pietrmar/theadmouse/hardware/RevA/Pin Assignment.ods

Pin
Module | nRF52840 | ADC | Fast-IO | Signal
1 | P1.11 |  |  | BTN_JACK_3
2 | P1.10 |  |  | BTN_JACK_2
3 | P0.03 | AIN1 |  | /SENS_MAG_CS
4 | P0.28 | AIN4 |  | VBAT_MEAS
5 | GND |  |  | GND
6 | P1.13 |  |  | BTN_JACK_1
7 | P0.02 | AIN0 |  | BTN_MFB
8 | P0.29 | AIN5 |  | SENS_MAG_DRDY
9 | P0.31 | AIN7 |  | SENS_IMU_INT_2
10 | P0.30 | AIN6 |  | SENS_IMU_INT_1
11 | P0.00 (XL1) |  | Yes | Y1
12 | P0.26 |  | Yes | LED_R
13 | P0.01 (XL2) |  | Yes | Y1
14 | P0.06 |  | Yes | LED_G
15 | P0.05 | AIN3 | Yes | SENS_SPI_MOSI
16 | P0.08 |  | Yes | LED_B
17 | P1.09 |  | Yes | SENS_SPI_SCLK
18 | P0.04 | AIN2 | Yes | SENS_SPI_MISO
19 | VDD |  |  | VDD_3V3
20 | P0.12 |  | Yes | EXT_I2C_SCL
21 | GND |  |  | GND
22 | P0.07 |  | Yes | EXT_I2C_SDA
23 | VDDH |  |  | VDD_3V3
24 | GND |  |  | GND
25 | DCCH |  |  | N.C.
26 | P0.18 (RESET) |  | Yes | /RESET
27 | VBUS |  |  | VBUS
28 | P0.15 |  | Yes | SPK_PWM
29 | USB_DN |  |  | USB_D-
30 | P0.17 |  | Yes | CHRG_I2C_SCL
31 | UDB_DP |  |  | USB_D+
32 | P0.20 |  | Yes | CHRG_I2C_SDA
33 | P0.13 |  | Yes | EXT_GPIO_1
34 | P0.22 |  | Yes | UART_TX
35 | P0.24 |  | Yes | UART_RX
36 | P1.00 (SWO) |  | Yes | SWO
37 | SWDIO |  |  | SWDIO
38 | P1.02 |  |  | /EXT_3V3_FAULT
39 | SWCLK |  |  | SWCLK
40 | P1.04 |  |  | EXT_3V3_EN
41 | P0.09 (NFC1) |  |  | EXT_GPIO_2
42 | P1.06 |  |  | /CHRG_INT
43 | P0.10 (NFC2) |  |  | /SENS_IMU_CS
