pietrmar/theadmouse/hardware/RevA/Stackup.ods

JLCPCB Stackup: JLC04161H-3313
Layer | Material | Thickness [mm] | εr | Signal | Mode | Target Z [Ω] | Width [mm] | Spacing [mm] | Actual Z [Ω]
L1 (Top) | Copper | 0.035 |  | SPI | Single-Ended | 50 | 0.15 |  | 49.815
Prepreg | 3313*1 | 0.0994 | 4.1 | USB | Differential | 90 | 0.15 | 0.17 | 90.38
L2 (Inner) | Copper | 0.0152
Core | Core | 1.265 | 4.6
L3 (Inner) | Copper | 0.0152
Prepreg | 3313*1 | 0.0994 | 4.1
L4 (Bottom) | Copper | 0.035
