pietrmar/theadmouse/hardware/3dmodels/SW_Push_1P1T-MP_NO_Horizontal_Alps_SKRTLAE010_Custom3D.step

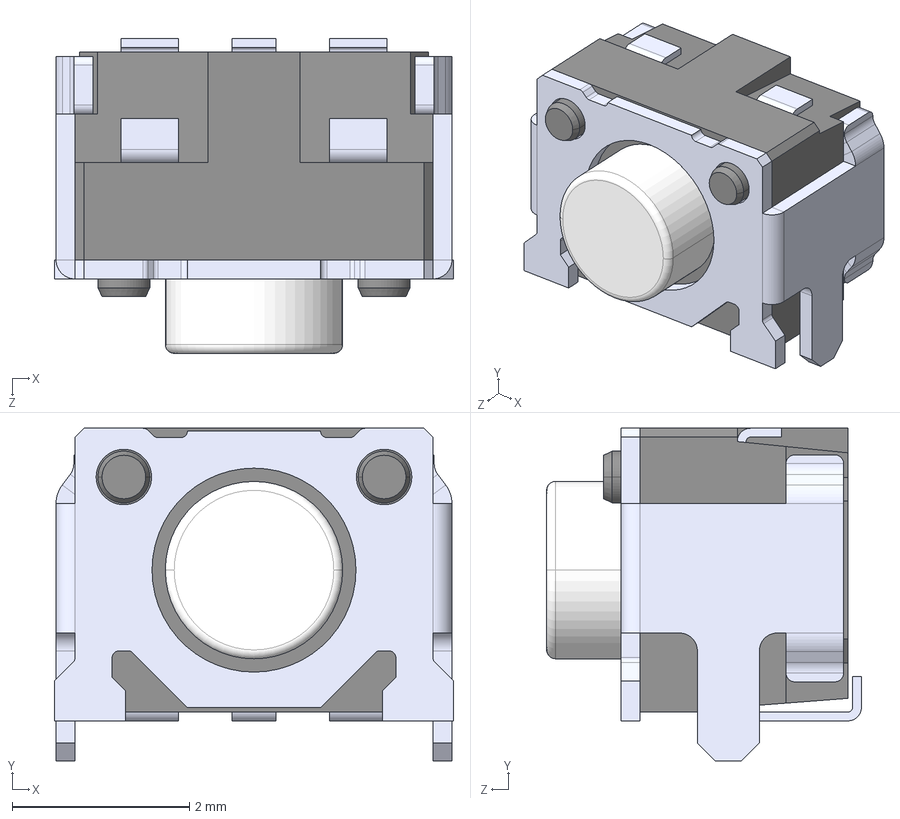
[picture p1: CAD file, 2025-08-08]
hardware/3dmodels/SW_Push_1P1T-MP_NO_Horizontal_Alps_SKRTLAE010_Custom3D.step
4.50 x 3.75 x 3.55 mm
