pietrmar/theadmouse/hardware/mechanical/components/LED_RGB_TUOZHAN_P4-1204RGBWS2-1.5T-A_Horizontal.FCStd

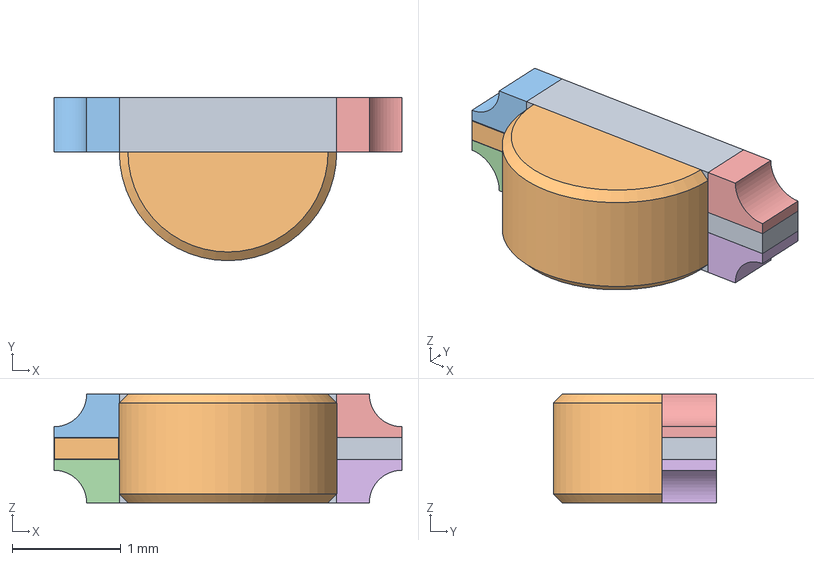
[picture p2: CAD file, 2025-08-08]
hardware/mechanical/components/LED_RGB_TUOZHAN_P4-1204RGBWS2-1.5T-A_Horizontal.FCStd
3.20 x 1.50 x 1.00 mm
Pad002 (Mirror #1)
Pad002 (Mirror #2)
Pad002 (Mirror #3)
Pad003 (Mirror #4)
