pietrmar/theadmouse/hardware/3dmodels/RJ25_TE_215876-1_Horizontal.step

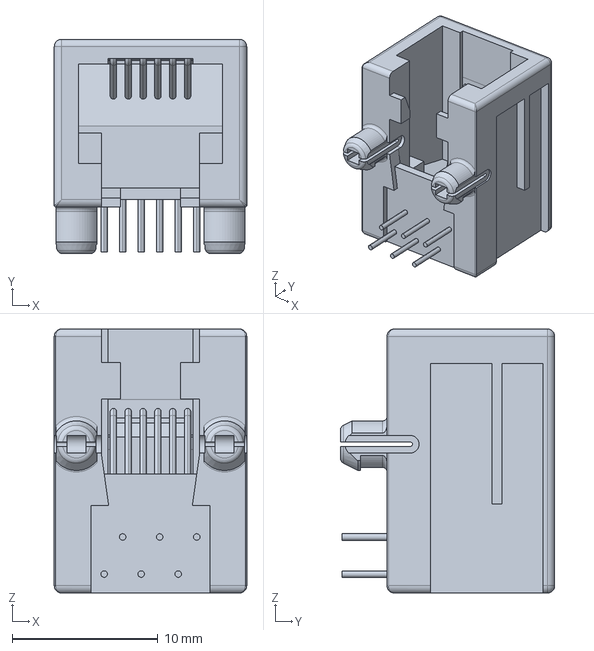
[picture p3: CAD file, 2025-08-08]
hardware/3dmodels/RJ25_TE_215876-1_Horizontal.step
13.2 x 14.7 x 18.1 mm
