pietrmar/theadmouse/hardware/mechanical/components/Buzzer_FUET_FST-9018_9x9mm.FCStd

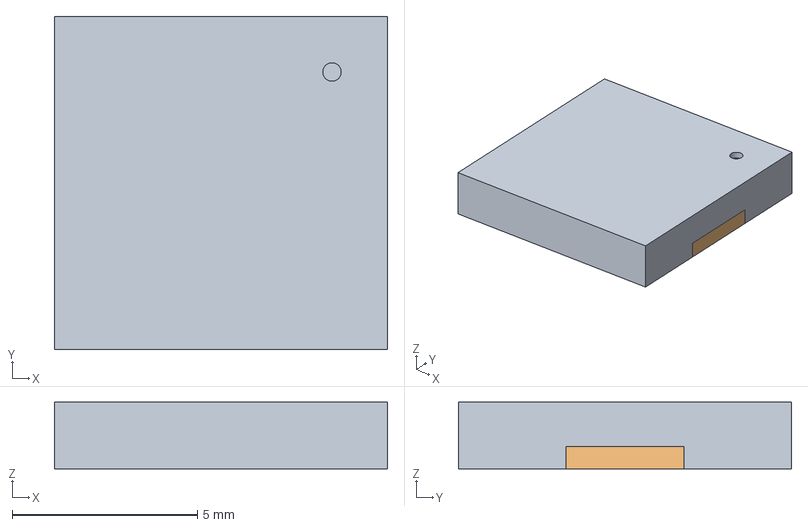
[picture p4: CAD file, 2025-08-08]
hardware/mechanical/components/Buzzer_FUET_FST-9018_9x9mm.FCStd
9.00 x 9.00 x 1.80 mm
Pad001 (Mirror #1)
