pietrmar/theadmouse/hardware/3dmodels/USB_C_Receptacle_HRO_TYPE-C-31-M-12_Custom3D.step

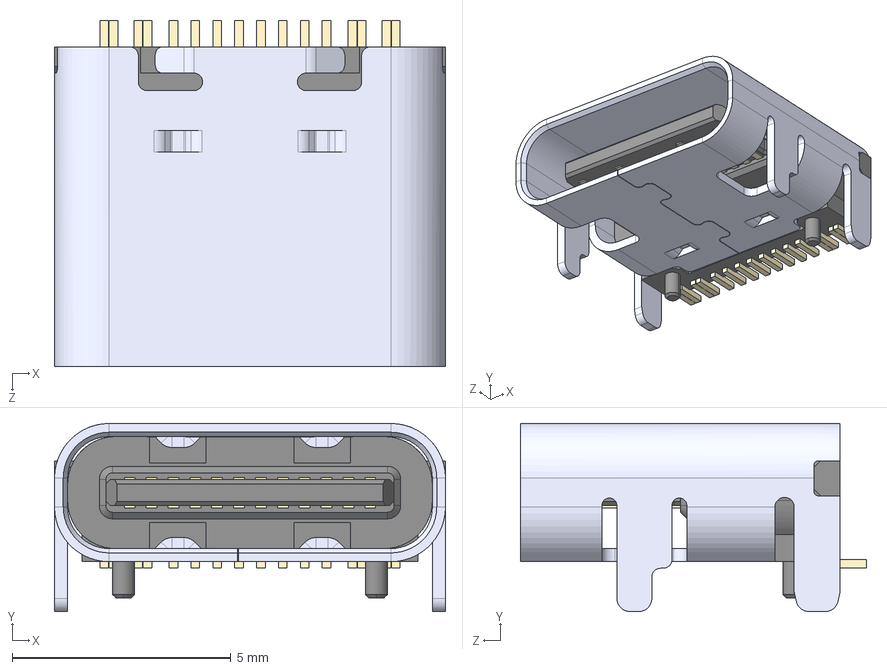
[picture p5: CAD file, 2025-08-08]
hardware/3dmodels/USB_C_Receptacle_HRO_TYPE-C-31-M-12_Custom3D.step
8.94 x 4.30 x 7.90 mm
