pietrmar/theadmouse/hardware/mechanical/components/LED_Green_MEIHUA_MHS110UGCT_Horizontal.FCStd

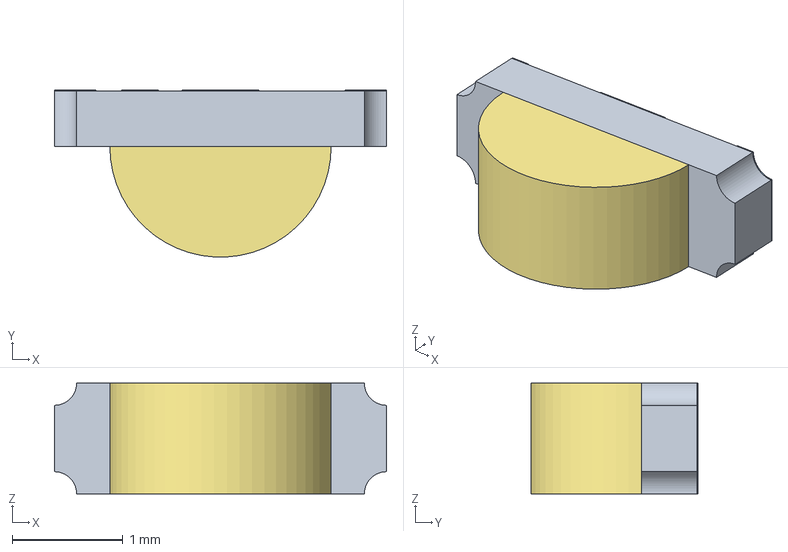
[picture p6: CAD file, 2025-08-08]
hardware/mechanical/components/LED_Green_MEIHUA_MHS110UGCT_Horizontal.FCStd
3.00 x 1.51 x 1.00 mm
Body001 (Mirror #1)
CopyPad001
