pietrmar/theadmouse/hardware/3dmodels/Jack_3.5mm_KoreanHropartsElec_PJ-320D-4A_Horizontal_Custom.step

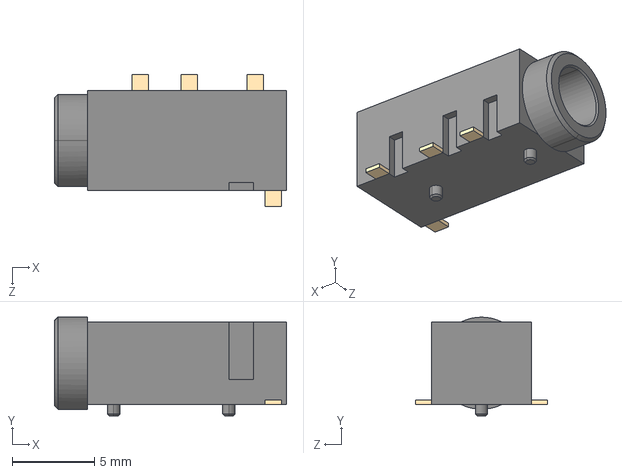
[picture p7: CAD file, 2025-08-08]
hardware/3dmodels/Jack_3.5mm_KoreanHropartsElec_PJ-320D-4A_Horizontal_Custom.step
14.1 x 6.00 x 8.00 mm
