pietrmar/theadmouse/hardware/3dmodels/SW_SPDT_ALPS_SSSS811101_SMT_Horizontal.step

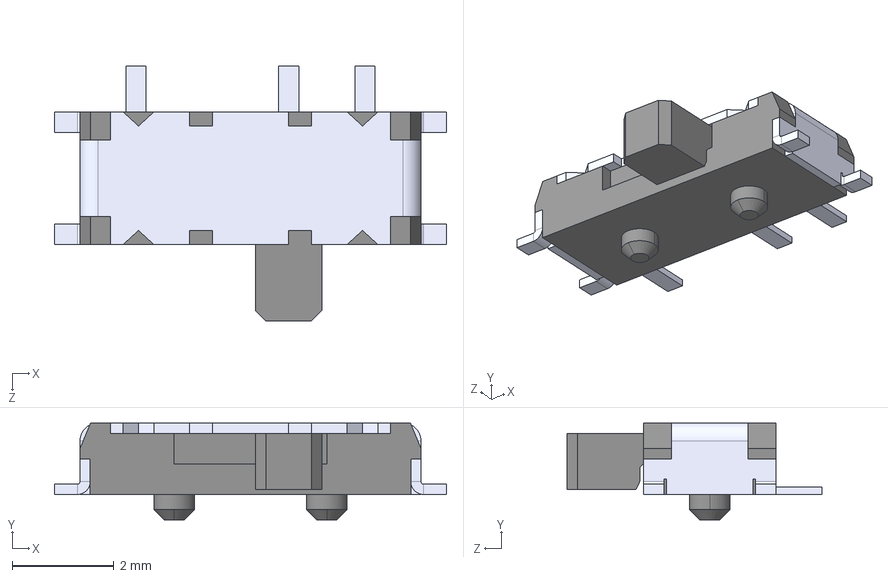
[picture p8: CAD file, 2025-08-08]
hardware/3dmodels/SW_SPDT_ALPS_SSSS811101_SMT_Horizontal.step
7.70 x 1.90 x 5.00 mm
