pietrmar/theadmouse/hardware/3dmodels/Module_RF_Ebyte_E73-2G4M08S1C_Castellated.step

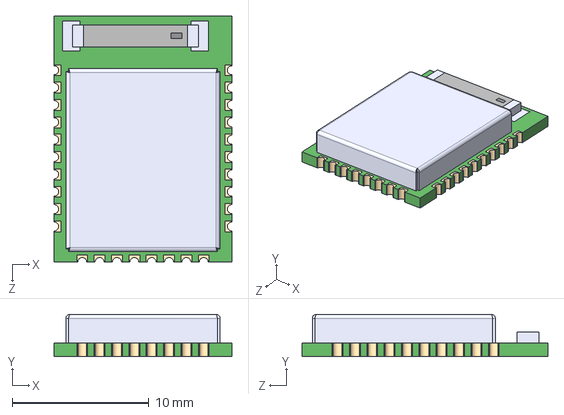
[picture p9: CAD file, 2025-08-08]
hardware/3dmodels/Module_RF_Ebyte_E73-2G4M08S1C_Castellated.step
13.0 x 3.10 x 18.0 mm
