pietrmar/theadmouse/hardware/RevA/pcb/theadmouse.kicad_pcb

## KiCad design hardware/RevA/pcb/theadmouse.kicad_pcb (2026-05-12)

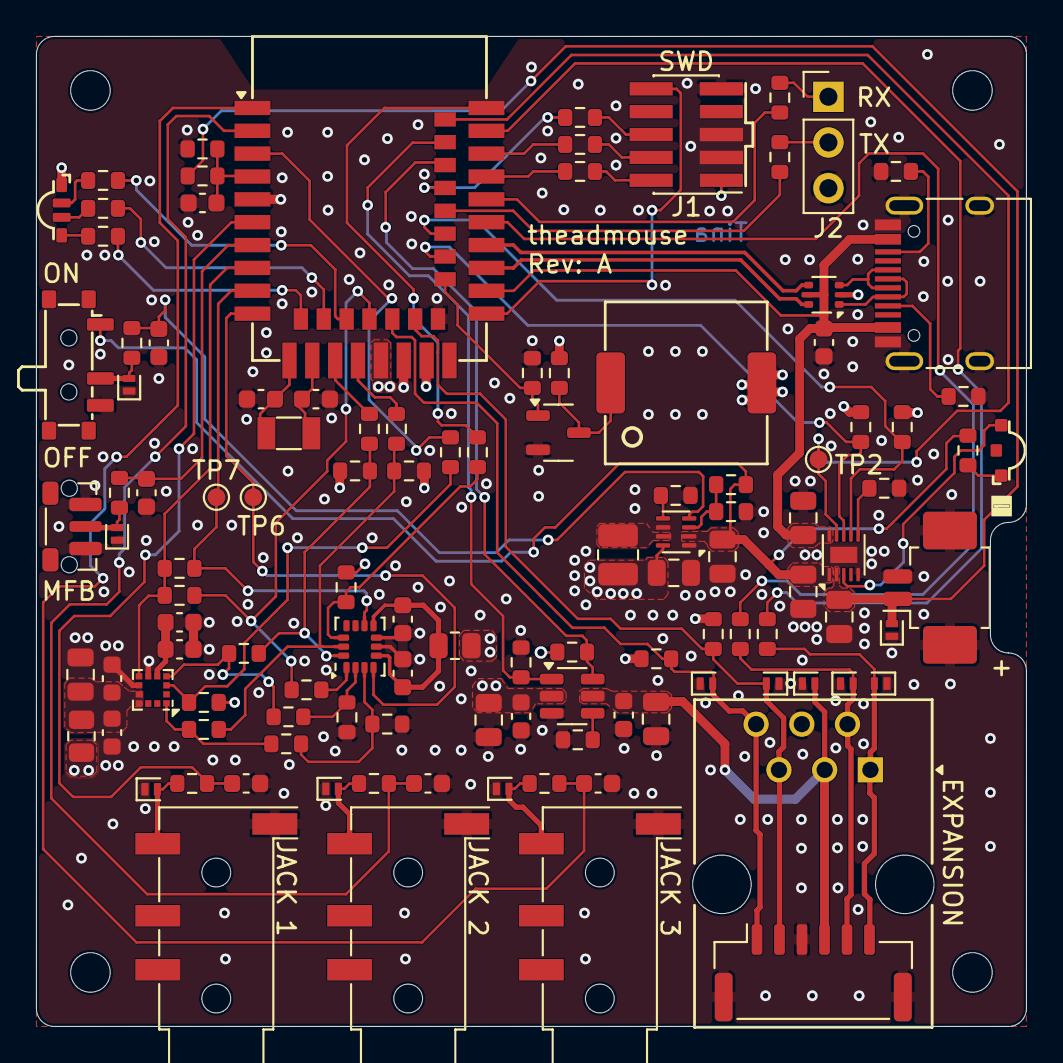
[picture p10: board theadmouse.kicad_pcb from above]

Board: 4 copper layers, 55.0 x 55.0 mm, 119 parts (0 on the bottom side), 82 nets.

Parts:
C1, C2: 15p; C_0603_1608Metric
C3, C8, C11, C13, C14, C15, C16, C17, C19, C26: 100n; C_0603_1608Metric
C4, C5, C6, C9, C10, C12, C18, C25: 10u; C_0805_2012Metric
C7, C21, C22, C23, C24: 10n; C_0603_1608Metric
D1, D2, D3, D4, D5, D6, D7, D8, D9, D10, D12: H5VL10B; D_SOD-882
D11: LED_STATUS; LED_RGB_TUOZHAN_P4-1204RGBWS2-1.5T-A_Horizontal
D13: LED_PGOOD; LED_Green_MEIHUA_MHS110UGCT_Horizontal
H1, H2, H3, H4: MountingHole; MountingHole_2.2mm_M2_ISO7380
J1: CON_SWD; PinHeader_2x05_P1.27mm_Vertical_SMD
J2: CON_UART; PinHeader_1x03_P2.54mm_Vertical
J4: TYPE-C-31-M-12; USB_C_Receptacle_HRO_TYPE-C-31-M-12_Custom3D
J5: CON_BAT; Molex_PicoBlade_53261-0271_1x02-1MP_P1.25mm_Horizontal
J6: CON_EXT; JST_GH_SM06B-GHS-TB_1x06-1MP_P1.25mm_Horizontal
J7: CON_EXT_RJ; RJ25_TE_215876-1_Horizontal
J8, J9, J10: PJ-320D-4A; Jack_3.5mm_KoreanHropartsElec_PJ-320D-4A_Horizontal_Custom
L1: 2u2; L_1008_2520Metric
LS1: FUET-9018; Buzzer_FUET_FST-9018_9x9mm
Q1: HL2312; SOT-23-3
R1, R2, R3, R4, R5, R6, R21, R30: 10k; R_0603_1608Metric
R7, R8, R11, R12, R41, R44, R45, R49: 100R; R_0603_1608Metric
R9, R10, R13, R14, R16, R17, R18, R53: 22R; R_0603_1608Metric
R19, R20: 5k1; R_0603_1608Metric
R22: 4M02; R_0603_1608Metric
R23: 10M; R_0603_1608Metric
R24, R26, R32, R34, R35, R36, R37, R38, R39, R40: 0R; R_0603_1608Metric
R25, R43: 100k; R_0603_1608Metric
R27: 4k3; R_0603_1608Metric
R28: 267k; R_0603_1608Metric
R29, R50, R51: 470k; R_0603_1608Metric
R31, R33: 0R; R_0805_2012Metric
R42: 1k; R_0603_1608Metric
R46: 470R; R_0603_1608Metric
R47: 390R; R_0603_1608Metric
R48: 270R; R_0603_1608Metric
R52: 1k5; R_0603_1608Metric
SW1: SW_PWR; SW_SPDT_ALPS_SSSS811101_SMT_Horizontal
SW2: SW_MFB; SW_Push_1P1T-MP_NO_Horizontal_Alps_SKRTLAE010_Custom3D
TP2: ~{CHRG_INT}; TestPoint_Pad_D1.0mm
TP6: SENS_IMU_INT1; TestPoint_Pad_D1.0mm
TP7: SENS_IMU_INT2; TestPoint_Pad_D1.0mm
U1: E73-2G4M08S1C; Module_RF_Ebyte_E73-2G4M08S1C_Castellated
U2: USBLC6-2P6; SOT-666
U3: BQ25186; Texas_DLH0010A_WSON-10-1EP_2.2x2mm_P0.4mm_EP0.9x1.5mm
U4: TPS22950; SOT-23-6
U5: TPS62840DLC; Texas_VSON-HR-8_1.5x2mm_P0.5mm
U6: LSM6DSL; LGA-14_3x2.5mm_P0.5mm_LayoutBorder3x4y
U7: LIS2MDL; LGA-12_2x2mm_P0.5mm
Y1: 32.768 kHz; Crystal_SMD_3215-2Pin_3.2x1.5mm

Connections:
/BTN_JACK_1: C21.2, R41.1, U1.6 (P1.13)
/BTN_JACK_2: C22.2, R44.1, U1.2 (P1.10)
/BTN_JACK_3: C23.2, R45.1, U1.1 (P1.11)
/BTN_MFB: C24.2, R49.1, U1.7 (P0.02/AIN0)
/CHRG_I2C_SCL: R1.2, U1.30 (P0.17), U3.8 (SCL)
/CHRG_I2C_SDA: R2.2, U1.32 (P0.20), U3.7 (SDA)
/EXT_3V3_EN: R29.1, U1.40 (P1.04), U4.1 (ON)
/EXT_GPIO_1: D4.2 (A2), J6.5 (Pin_2), J7.2, R11.2
/EXT_GPIO_2: D3.2 (A2), J6.6 (Pin_1), J7.1, R12.1
/EXT_I2C_SCL: D7.2 (A2), J6.1 (Pin_6), J7.6, R5.2, U1.20 (P0.12)
/EXT_I2C_SDA: D6.2 (A2), J6.2 (Pin_5), J7.5, R6.2, U1.22 (P0.07)
/LED_B: R48.2, U1.16 (P0.08)
/LED_G: R47.2, U1.14 (P0.06)
/LED_R: R46.2, U1.12 (P0.26)
/Power/~CHRG_PG: D13.1 (K), U3.3 (~PG/GPO)
/SENS_IMU_INT_1: TP6.1, U1.10 (P0.30/AIN6), U6.4 (INT1)
/SENS_IMU_INT_2: R32.2, TP7.1, U1.9 (P0.31/AIN7), U6.9 (INT2)
/SENS_MAG_DRDY: R32.1, R40.2, U1.8 (P0.29/AIN5), U7.7 (DRDY)
/SENS_SPI_MISO: R40.1, R53.2, U1.18 (P0.04/AIN2)
/SENS_SPI_MOSI: R4.2, R13.1, R39.2, U6.14 (SDA)
/SENS_SPI_SCLK: R3.2, R14.1, R38.2, U6.13 (SCL)
/SPK_PWM: Q1.1 (G), R43.2, U1.28 (P0.15)
/SWCLK: J1.4, R10.2
/SWDIO: J1.2, R9.1
/SWO: J1.6, R16.2
/UART_RX: J2.1, R8.1
/UART_TX: J2.2, R7.2
/USB_D+: U1.31 (DP), U2.4 (I/O2)
/USB_D-: U1.29 (DM), U2.6 (I/O1)
/VBAT_MEAS: C7.1, R22.2, R23.1, U1.4 (P0.28/AIN4)
/~CHRG_INT: TP2.1, U1.42 (P1.06), U3.9 (~INT)
/~EXT_3V3_FAULT: R25.2, U1.38 (P1.02), U4.6 (~FLT)
/~RESET: J1.10, U1.26 (P0.18/RESET)
/~SENS_IMU_CS: R17.1, R50.2, U6.12 (CS)
/~SENS_MAG_CS: R18.2, R51.2, U7.3 (~CS)
EXT_3V3: C8.1, C9.1, D5.2 (A2), J6.4 (Pin_3), J7.3, U4.5 (VOUT)
GND: C1.2, C2.2, C3.2, C4.2, C5.2, C6.2, C7.2, C8.2, C9.2, C10.2, C11.2, C12.2, C13.2, C14.2, C15.2, C16.2, C17.2, C18.2, C19.2, C21.1, C22.1, C23.1, C24.1, C25.2, C26.2, D1.1 (A1), D2.1 (A1), D3.1 (A1), D4.1 (A1), D5.1 (A1), D6.1 (A1), D7.1 (A1), D8.1 (A1), D9.1 (A1), D10.1 (A1), D12.1 (A1), J1.3, J1.5, J1.9, J2.3, J4.A1 (GND), J4.A12 (GND), J4.B1 (GND), J4.B12 (GND), J4.S1 (SHIELD), J5.2, J5.MP (MountPin), J6.3 (Pin_4), J6.MP (MountPin), J7.4, J8.G, J9.G, J10.G, Q1.2 (S), R19.2, R20.2, R21.1, R23.2, R26.1, R27.2, R28.1, R29.2, R36.1, R37.2, R43.1, SW1.3 (A), SW2.1, U1.5 (GND@1), U1.21 (GND@2), U1.24 (GND@3), U2.2 (GND), U3.5 (GND), U3.11 (THERMAL), U4.3 (GND), U5.1 (GND), U5.6 (STOP), U6.6 (GND), U6.7 (GND), U7.6 (GND), U7.8 (GND)
unnamed: D2.2 (A2), R30.1, SW1.2 (B)
unnamed: D8.2 (A2), J8.T, R41.2
unnamed: D9.2 (A2), J9.T, R44.2
unnamed: D10.2 (A2), J10.T, R45.2
unnamed: D11.2 (BK), R48.1
unnamed: D11.1 (GK), R47.1
unnamed: D11.3 (RK), R46.1
unnamed: D12.2 (A2), R49.2, SW2.2
unnamed: D13.2 (A), R52.1
unnamed: J4.A5 (CC1), R20.1
unnamed: J4.B5 (CC2), R19.1
unnamed: J4.A6 (D+), J4.B6 (D+), U2.3 (I/O2)
unnamed: J4.A7 (D-), J4.B7 (D-), U2.1 (I/O1)
unnamed: LS1.2, Q1.3 (D), R42.1
unnamed: R10.1, U1.39 (SWDCLK)
unnamed: R9.2, U1.37 (SWDIO)
unnamed: C1.1, U1.11 (P0.00/XL1), Y1.2
unnamed: C2.1, U1.13 (P0.01/XL2), Y1.1
unnamed: R18.1, U1.3 (P0.03/AIN1)
unnamed: R13.2, U1.15 (P0.05/AIN3)
unnamed: R12.2, U1.41 (P0.09/NFC1)
unnamed: R17.2, U1.43 (P0.10/NFC2)
unnamed: R11.1, U1.33 (P0.13)
unnamed: R7.1, U1.34 (P0.22)
unnamed: R8.2, U1.35 (P0.24)
unnamed: R16.1, U1.36 (P1.00)
unnamed: R14.2, U1.17 (P1.09)
unnamed: R21.2, U3.6 (TS/MR)
unnamed: R27.1, U4.4 (ILIM)
unnamed: C13.1, R30.2, U5.4 (EN)
unnamed: R24.1, R26.2, U5.3 (MODE)
unnamed: L1.1, U5.7 (SW)
unnamed: R28.2, U5.5 (VSET)
unnamed: R35.1, R36.2, U6.3 (SCX)
unnamed: R53.1, U6.1 (SDO/SA0)
unnamed: R34.2, R37.1, U6.2 (SDX)
unnamed: C14.1, C15.1, R31.1, U6.5 (VDDIO), U6.8 (VDD)
unnamed: C19.1, C26.1, U7.5 (C1)
unnamed: R35.2, R38.1, U7.1 (SCL/SPC)
unnamed: R34.1, R39.1, U7.4 (SDA/SDI/SDO)
unnamed: C16.1, C17.1, C18.1, R33.1, U7.9 (Vdd), U7.10 (Vdd_IO)
VBAT: C6.1, D1.2 (A2), J5.1, R22.1, U3.2 (BAT)
VBUS: C3.1, C4.1, J4.A4 (VBUS), J4.A9 (VBUS), J4.B4 (VBUS), J4.B9 (VBUS), U1.27 (VBUS), U2.5 (VBUS), U3.10 (IN)
VDD_3V3: C10.1, C11.1, C25.1, D11.4 (A), J1.1, L1.2, LS1.1, R1.1, R2.1, R3.1, R4.1, R5.1, R6.1, R25.1, R31.2, R33.2, R42.2, R50.1, R51.1, U1.19 (VDD), U1.23 (VDDH), U4.2 (VIN), U5.8 (VOS)
VSYS: C5.1, C12.1, R24.2, R52.2, SW1.1 (C), U3.1 (SYS), U5.2 (VIN)
