pietrmar/theadmouse/firmware/src/motion_engine.c

#include <zephyr/device.h>
#include <zephyr/drivers/sensor.h>
#include <zephyr/logging/log.h>
#include <zephyr/sys/byteorder.h>
#include <zephyr/input/input.h>
#include <zephyr/pm/device.h>

#include <zsl/orientation/orientation.h>

#include "common.h"

#include "headmouse_input.h"
#include "motion_engine.h"
#include "telemetry_uart.h"

#include "MadgwickAHRS/MadgwickAHRS.h"

LOG_MODULE_REGISTER(motion_engine, CONFIG_MOTION_ENGINE_LOG_LEVEL);

#if DT_NODE_HAS_STATUS_OKAY(DT_CHOSEN(mpi_imu))
static const struct device *const dev_imu = DEVICE_DT_GET(DT_CHOSEN(mpi_imu));
#else
static const struct device *const dev_imu = NULL;
#endif

#if DT_NODE_HAS_STATUS_OKAY(DT_CHOSEN(mpi_mag))
static const struct device *const dev_mag = DEVICE_DT_GET(DT_CHOSEN(mpi_mag));
#else
static const struct device *const dev_mag = NULL;
#endif


// Possible values for the LSM6DSL from the datasheet:
//   1.6, 12.5, 26, 52, 104, 208, 416, 833, 1666, 3332, 6664
#define IMU_SAMPLING_FREQUENCY	416.0f

// Posible values for the LIS2MDL from the datasheet:
//   10, 20, 50, 100
#define MAG_SAMPLING_FREQUENCY	50.0f

// MAG_DECIM_FACTOR = ceil(IMU_SAMPLING_FREQUENCY / MAG_SAMPLING_FREQUENCY)
#define MAG_DECIM_FACTOR	((uint32_t)((IMU_SAMPLING_FREQUENCY + MAG_SAMPLING_FREQUENCY - 1) / MAG_SAMPLING_FREQUENCY))


static atomic_t imu_trigger_count = ATOMIC_INIT(0);

static atomic_t accel_clip_count = ATOMIC_INIT(0);
static atomic_t gyro_clip_count = ATOMIC_INIT(0);
float accel_clip_limit = 0.0f;
float gyro_clip_limit = 0.0f;

static K_SEM_DEFINE(imu_trigger_sem, 0, 1);
static void imu_trigger_handler(const struct device *dev, const struct sensor_trigger *trig)
{
	atomic_inc(&imu_trigger_count);
	k_sem_give(&imu_trigger_sem);
}


// To prevent aliasing effects, the IMU thread calculates the delta motion between samples and
// accumulates them in the `imu_acuum_[x|y]` accumulator. The HID thread will fetch and clear
// this accumulator at a lower rate when needed. This ensures we do not "lose" position updates
// and every IMU update was correctly accumulated.
static float imu_accum_x = 0.0f;
static float imu_accum_y = 0.0f;
static struct k_spinlock imu_accum_lock;

#ifdef CONFIG_TELEMETRY

static inline int feed_telemetry(uint32_t sample_id, const struct zsl_vec *a, const struct zsl_vec *g, const struct zsl_vec *m, const struct zsl_quat *q, float t)
{
#if !IS_ENABLED(CONFIG_TELEMETRY_PLAINTEXT)
#define TELEMETRY_PAYLOAD_LEN	60	// 1*4 (uint32_t) + 14*4 (float)

	//  1 * 4 bytes (uint32_t), sample_id
	// 14 * 4 bytes (float), a(3), g(3), m(3), q(4), t(1)
	const size_t telemetry_payload_len = 60;
	// 2 (sync) + 1 (version) + 2 (length) + payload + 1 (checksum)
	const size_t buffer_size = 2 + 1 + 2 + telemetry_payload_len + 1;
	uint8_t buf[buffer_size];
	size_t idx = 0;

	// sync bytes
	buf[idx++] = 0xaa;
	buf[idx++] = 0x55;

	// Version
	buf[idx++] = 0x01;

	// Payload length
	sys_put_le16(TELEMETRY_PAYLOAD_LEN, &buf[idx]);
	idx += 2;

	// Sample ID
	sys_put_le32(sample_id, &buf[idx]);
	idx +=4;

#define PACK_F32(_buf, _idx, _value) do {		\
	float _v = (_value);				\
	memcpy(&(_buf)[(_idx)], &_v, sizeof(_v));	\
	(_idx) += sizeof(_v);				\
} while (0)

	PACK_F32(buf, idx, a->data[0]);
	PACK_F32(buf, idx, a->data[1]);
	PACK_F32(buf, idx, a->data[2]);

	PACK_F32(buf, idx, g->data[0]);
	PACK_F32(buf, idx, g->data[1]);
	PACK_F32(buf, idx, g->data[2]);

	PACK_F32(buf, idx, m->data[0]);
	PACK_F32(buf, idx, m->data[1]);
	PACK_F32(buf, idx, m->data[2]);

	PACK_F32(buf, idx, q->r);
	PACK_F32(buf, idx, q->i);
	PACK_F32(buf, idx, q->j);
	PACK_F32(buf, idx, q->k);

	PACK_F32(buf, idx, t);

#undef PACK_F32

	// Sanity check before the checksum
	if (idx != (buffer_size - 1)) {
		// TODO: Maybe do an assert here
		return -EFAULT;
	}

	uint8_t checksum = 0;
	for (size_t i = 2; i < idx; i++) {
		checksum = (uint8_t)(checksum + buf[i]);
	}
	buf[idx++] = checksum;

	return telemetry_uart_write(buf, idx);
#else
	// NOTE: This is slow, like up to 1.9 ms slow, most likely becasue of float formatting
	return telemetry_uart_printf("S,%u,%f,%f,%f,%f,%f,%f,%f,%f,%f,%f,%f,%f,%f,%f\r\n",
			sample_id,
			(double)a->data[0], (double)a->data[1], (double)a->data[2],
			(double)g->data[0], (double)g->data[1], (double)g->data[2],
			(double)m->data[0], (double)m->data[1], (double)m->data[2],
			(double)q->r, (double)q->i, (double)q->j, (double)q->k,
			(double)t);
#endif // !IS_ENABLED(CONFIG_TELEMETRY_PLAINTEXT)
}
#endif


// Posible values from the data-sheet in g:
//  2, 4, 8, 16
#define LSM6DSL_ACC_FULL_SCALE	8

// Possible values from the data-sheet deg/s:
//  125, 250, 500, 1000, 2000
#define LSM6DSL_GYR_FULL_SCALE	1000



static void imu_thread(void *, void *, void *)
{
	int ret;

	struct zsl_quat q_prev = {
		.r = 1.0f, .i = 0.0f, .j = 0.0f, .k = 0.0f
	};

	struct zsl_quat q_curr = {
		.r = 1.0f, .i = 0.0f, .j = 0.0f, .k = 0.0f
	};

	// Madgwick setup
	beta = 0.1;
	sampleFreq = IMU_SAMPLING_FREQUENCY;


#ifdef CONFIG_TELEMETRY
	// For the telemetry stream we need to keep a copy of the last mag value read
	// from our loop as the MAG_DECIM_FACTOR and CONFIG_TELEMETRY_DECIM_FACTOR are not the
	// same and "unlocked";
	bool telemetry_mag_valid = false;
	ZSL_VECTOR_DEF(telemetry_mag, 3);
	zsl_vec_init(&telemetry_mag);
#endif

	ZSL_VECTOR_DEF(gyro_bias, 3);
	zsl_vec_init(&gyro_bias);

	bool first_position_estimate = true;

	uint32_t sample_idx = 0;
	while (true) {
		k_sem_take(&imu_trigger_sem, K_FOREVER);

		int64_t t_start = k_uptime_ticks();

		// TODO: Verify that we are actually fetching correctly both fresh samples
		// from the IMU and not that one of them is stale.
		ret = sensor_sample_fetch_chan(dev_imu, SENSOR_CHAN_ALL);
		if (ret < 0) {
			LOG_ERR("Failed to fetch IMU sample: %d", ret);
			continue;
		}
		sample_idx++;

		bool mag_fetched = false;
		if ((sample_idx % MAG_DECIM_FACTOR) == 0) {
			ret = sensor_sample_fetch_chan(dev_mag, SENSOR_CHAN_MAGN_XYZ);
			if (ret < 0) {
				LOG_ERR("Failed to fetch magnetometer sample: %d", ret);
			}
			mag_fetched = true;
		}

		// TODO: Drop 50 Mag samples or determine stability
		// TODO: Drop 200 IMU samples or determine stability

		// Fetch accelerometer data
		struct sensor_value acc_val[3];
		sensor_channel_get(dev_imu, SENSOR_CHAN_ACCEL_XYZ, acc_val);	// In m/s²
		ZSL_VECTOR_DEF(raw_acc, 3);
		raw_acc_vec[0] = sensor_value_to_float(&acc_val[0]);
		raw_acc_vec[1] = sensor_value_to_float(&acc_val[1]);
		raw_acc_vec[2] = sensor_value_to_float(&acc_val[2]);

		bool accel_clip = ZSL_ABS(raw_acc_vec[0]) >= accel_clip_limit ||
				  ZSL_ABS(raw_acc_vec[1]) >= accel_clip_limit ||
				  ZSL_ABS(raw_acc_vec[2]) >= accel_clip_limit;
		if (accel_clip)
			atomic_inc(&accel_clip_count);

		// Fetch gyro data
		struct sensor_value gyro_val[3];
		sensor_channel_get(dev_imu, SENSOR_CHAN_GYRO_XYZ, gyro_val);	// In rad/s
		ZSL_VECTOR_DEF(raw_gyr, 3);
		raw_gyr_vec[0] = sensor_value_to_float(&gyro_val[0]);
		raw_gyr_vec[1] = sensor_value_to_float(&gyro_val[1]);
		raw_gyr_vec[2] = sensor_value_to_float(&gyro_val[2]);

		bool gyro_clip = ZSL_ABS(raw_gyr_vec[0]) >= gyro_clip_limit ||
				 ZSL_ABS(raw_gyr_vec[1]) >= gyro_clip_limit ||
				 ZSL_ABS(raw_gyr_vec[2]) >= gyro_clip_limit;
		if (gyro_clip)
			atomic_inc(&gyro_clip_count);

		ZSL_VECTOR_DEF(raw_mag, 3);
		if (mag_fetched) {
			struct sensor_value mag_val[3];
			sensor_channel_get(dev_mag, SENSOR_CHAN_MAGN_XYZ, mag_val);	// In Gauss
			raw_mag_vec[0] = sensor_value_to_float(&mag_val[0]);
			raw_mag_vec[1] = sensor_value_to_float(&mag_val[1]);
			raw_mag_vec[2] = sensor_value_to_float(&mag_val[2]);
			mag_fetched = true;

#ifdef CONFIG_TELEMETRY
			telemetry_mag_vec[0] = raw_mag_vec[0];
			telemetry_mag_vec[1] = raw_mag_vec[1];
			telemetry_mag_vec[2] = raw_mag_vec[2];
			telemetry_mag_valid = true;
#endif
		}

		// TODO: Handle clipping somehow

		zsl_real_t acc_norm = zsl_vec_norm(&raw_acc);
		zsl_real_t gyr_norm = zsl_vec_norm(&raw_gyr);
		// TODO: Make use of the magnetometer
		zsl_real_t mag_norm = zsl_vec_norm(&raw_mag);

		bool acc_static = false;
		if (ZSL_ABS(acc_norm - 9.81f) < 0.5f)
			acc_static = true;

		bool gyr_static = false;
		if (gyr_norm < 0.09f)
			gyr_static = true;

		ZSL_VECTOR_DEF(accel, 3);
		zsl_vec_copy(&accel, &raw_acc);
		zsl_vec_to_unit(&accel);

		if (acc_static && gyr_static) {
			const zsl_real_t alpha = (1.0f / IMU_SAMPLING_FREQUENCY) / 2.0f;

			// gyro_bias = gyro_bias * (1.0 - alpha) + raw_gyr * alpha

			// tmp1 = gyro_bias * (1 - alpha)
			ZSL_VECTOR_DEF(tmp1, 3);
			zsl_vec_copy(&tmp1, &gyro_bias);
			zsl_vec_scalar_mult(&tmp1, 1.0f - alpha);

			// tmp2 = raw_gyr * alpha
			ZSL_VECTOR_DEF(tmp2, 3);
			zsl_vec_copy(&tmp2, &raw_gyr);
			zsl_vec_scalar_mult(&tmp2, alpha);

			// gyro_bias = tmp1 + tmp2
			zsl_vec_add(&tmp1, &tmp2, &gyro_bias);
		}
		ZSL_VECTOR_DEF(gyro, 3);
		zsl_vec_sub(&raw_gyr, &gyro_bias, &gyro);


		MadgwickAHRSupdateIMU(gyro_vec[0], gyro_vec[1], gyro_vec[2], accel_vec[0], accel_vec[1], accel_vec[2]);

		q_curr.r = q0;
		q_curr.i = q1;
		q_curr.j = q2;
		q_curr.k = q3;

		// Compute delta rotation:
		//  q_delta = q_curr * q_prev^(-1)
		struct zsl_quat q_prev_conj;
		zsl_quat_conj(&q_prev, &q_prev_conj);

		struct zsl_quat q_delta;
		zsl_quat_mult(&q_curr, &q_prev_conj, &q_delta);

		q_prev = q_curr;

#if 1
		struct zsl_euler e;
		zsl_quat_to_euler(&q_delta, &e);
		float raw_dx = e.z;
		float raw_dy = e.y;
#else
		// Approximation becuase `sin(x) = x` for small-ish x.
		float raw_dx = 2.0f * q_delta.k;
		float raw_dy = 2.0f * q_delta.j;
#endif
		// If this was the first position estimate just do not accumulate anything
		// by setting `raw_dx`, and `raw_dy` to false, becasue on the first iteration
		// `q_prev` was just set to the identity quaternion.
		if (first_position_estimate) {
			first_position_estimate = false;
			raw_dx = 0.0f;
			raw_dy = 0.0f;
		}

		k_spinlock_key_t key = k_spin_lock(&imu_accum_lock);
		imu_accum_x -= raw_dx;
		imu_accum_y += raw_dy;
		k_spin_unlock(&imu_accum_lock, key);

#ifdef CONFIG_TELEMETRY
		if ((sample_idx % CONFIG_TELEMETRY_DECIM_FACTOR) == 0) {
			struct sensor_value temp;
			sensor_channel_get(dev_imu, SENSOR_CHAN_DIE_TEMP, &temp);
			float t = sensor_value_to_float(&temp);

			if (telemetry_mag_valid) {
				telemetry_mag_valid = false;
			} else {
				telemetry_mag_vec[0] = 0.0f;
				telemetry_mag_vec[1] = 0.0f;
				telemetry_mag_vec[2] = 0.0f;
			}

			feed_telemetry(sample_idx, &raw_acc, &raw_gyr, &telemetry_mag, &q_curr, t);
		}
#endif

		int64_t t_end = k_uptime_ticks();

		if ((sample_idx % (uint32_t)IMU_SAMPLING_FREQUENCY) == 0) {
			// LOG_DBG("loop time: %lld us", k_ticks_to_us_near64(t_end - t_start));
			// LOG_DBG("gyro bias: [%f, %f, %f]", (double)gyro_bias_vec[0], (double)gyro_bias_vec[1], (double)gyro_bias_vec[2]);
		}
	}
}
// NOTE: `imu_trigger_handler()` should run at `-2`, and the `imu_thread` then one
// prio lower at `-1`.
K_THREAD_DEFINE(imu_tid, 2048, imu_thread, NULL, NULL, NULL, K_PRIO_COOP(1), 0, 0);

struct motion_config {
	enum mouse_mode mouse_mode;

	float acceleration[2];
	float deadzone[2];
	float maximum_speed;
	float acceleration_time;
};

struct motion_state {
	float absolute_pos[2];
};

struct motion_ctx {
	struct motion_config cfg;
	struct motion_state state;
	struct k_spinlock lock;
};

static struct motion_ctx ctx = {
	.cfg = {
		.mouse_mode = MOUSE_MODE_MOUSE,

		.acceleration = { 128.0f, 128.0f },
		.deadzone = { 5.0f, 5.0f },
		.maximum_speed = 50.0f,
		.acceleration_time = 50.0f,
	},
};

enum mouse_mode motion_engine_get_mouse_mode(void)
{
	k_spinlock_key_t key = k_spin_lock(&ctx.lock);
	enum mouse_mode m = ctx.cfg.mouse_mode;
	k_spin_unlock(&ctx.lock, key);

	return m;
}

int motion_engine_set_mouse_mode(enum mouse_mode m)
{
	if (m >= MOUSE_MODE_MAX)
		return -EINVAL;

	k_spinlock_key_t key = k_spin_lock(&ctx.lock);
	ctx.cfg.mouse_mode = m;
	k_spin_unlock(&ctx.lock, key);

	return 0;
}

int motion_engine_get_absolute_pos(float *x, float *y)
{
	k_spinlock_key_t key = k_spin_lock(&ctx.lock);
	*x = ctx.state.absolute_pos[AXIS_X];
	*y = ctx.state.absolute_pos[AXIS_Y];
	k_spin_unlock(&ctx.lock, key);

	return 0;
}

// TODO: Depending on what kind of orientation algorithm we use here it might make
// sense to reset/reinitialize the IMU/orientation estimation state too.
void motion_engine_reset_absolute_pos(void)
{
	k_spinlock_key_t key = k_spin_lock(&ctx.lock);
	ctx.state.absolute_pos[AXIS_X] = 0.0f;
	ctx.state.absolute_pos[AXIS_Y] = 0.0f;
	k_spin_unlock(&ctx.lock, key);
}


int motion_engine_set_acceleration(float v, enum axis axis)
{
	if (axis >= ARRAY_SIZE(ctx.cfg.acceleration))
		return -EINVAL;

	k_spinlock_key_t key = k_spin_lock(&ctx.lock);
	ctx.cfg.acceleration[axis] = v;
	k_spin_unlock(&ctx.lock, key);

	return 0;
}

float motion_engine_get_acceleration(enum axis axis)
{
	if (axis >= ARRAY_SIZE(ctx.cfg.acceleration))
		return -EINVAL;

	k_spinlock_key_t key = k_spin_lock(&ctx.lock);
	float v = ctx.cfg.acceleration[axis];
	k_spin_unlock(&ctx.lock, key);

	return v;
}

int motion_engine_set_deadzone(float v, enum axis axis)
{
	if (axis >= ARRAY_SIZE(ctx.cfg.deadzone))
		return -EINVAL;

	k_spinlock_key_t key = k_spin_lock(&ctx.lock);
	ctx.cfg.deadzone[axis] = v;
	k_spin_unlock(&ctx.lock, key);

	return 0;
}

float motion_engine_get_deadzone(enum axis axis)
{
	if (axis >= ARRAY_SIZE(ctx.cfg.deadzone))
		return -EINVAL;

	k_spinlock_key_t key = k_spin_lock(&ctx.lock);
	float v = ctx.cfg.deadzone[axis];
	k_spin_unlock(&ctx.lock, key);

	return v;
}

static const struct device *const btn_dev = DEVICE_DT_GET(DT_CHOSEN(mpi_buttons));

K_SEM_DEFINE(hid_report_sem, 0, 1);
static void hid_report_cb(struct k_timer *timer)
{
	k_sem_give(&hid_report_sem);
}
K_TIMER_DEFINE(hid_report_timer, hid_report_cb, NULL);

#define HID_REPORT_INTERVAL K_MSEC(10)

static void hid_report_thread(void *, void *, void *)
{
	// TODO: Reset all of these on mode change
	float remainder_x = 0.0f;
	float remainder_y = 0.0f;
	bool alt_mode_hits[4] = { false };

	k_timer_start(&hid_report_timer, HID_REPORT_INTERVAL, HID_REPORT_INTERVAL);

	while (true) {
		k_sem_take(&hid_report_sem, K_FOREVER);

		k_spinlock_key_t key = k_spin_lock(&imu_accum_lock);
		float raw_dx = imu_accum_x;
		float raw_dy = imu_accum_y;
		imu_accum_x = 0.0f;
		imu_accum_y = 0.0f;
		k_spin_unlock(&imu_accum_lock, key);

		// Make a "snapshot" of the config
		key = k_spin_lock(&ctx.lock);
		struct motion_config cfg = ctx.cfg;
		k_spin_unlock(&ctx.lock, key);

		// TODO: Do something more advanced than just a multiplication by the acceleration
		float move_dx = raw_dx * cfg.acceleration[AXIS_X];
		float move_dy = raw_dy * cfg.acceleration[AXIS_Y];

		// Update the absolute position and also make a snapshot of it for further processing
		key = k_spin_lock(&ctx.lock);
		ctx.state.absolute_pos[AXIS_X] += move_dx;
		ctx.state.absolute_pos[AXIS_Y] += move_dy;

		struct motion_state state = ctx.state;
		k_spin_unlock(&ctx.lock, key);

		if (cfg.mouse_mode == MOUSE_MODE_MOUSE) {
			// Because we can only transmit whole pixel values and thus we are rounding
			// to the nearest integer. So there might be a float reminder left which is
			// up to half a pixel. This mechanism makes sure that this remainder is not
			// lost and correctly included in the next HID update calculation.
			// TODO: Figure out how to keep/handle this correctly across mode changes
			remainder_x += move_dx;
			remainder_y += move_dy;

			int16_t idx = roundf(remainder_x);
			int16_t idy = roundf(remainder_y);

			if (idx != 0 || idy != 0)
				hm_input_report_mouse_move(idx, idy, K_FOREVER);

			remainder_x -= idx;
			remainder_y -= idy;
		} else if (cfg.mouse_mode == MOUSE_MODE_ALT) {
			bool hit[4] = { false };

			// TODO: Probably we would want to add a bit of hysteresis here

			if (state.absolute_pos[AXIS_X] > cfg.deadzone[AXIS_X])
				hit[DIR_RIGHT] = true;
			else if (state.absolute_pos[AXIS_X] < -cfg.deadzone[AXIS_X])
				hit[DIR_LEFT] = true;

			if (state.absolute_pos[AXIS_Y] > cfg.deadzone[AXIS_Y])
				hit[DIR_DOWN] = true;
			else if (state.absolute_pos[AXIS_Y] < -cfg.deadzone[AXIS_Y])
				hit[DIR_UP] = true;

			static const uint16_t zephyr_codes[4] = { INPUT_KEY_UP, INPUT_KEY_DOWN, INPUT_KEY_LEFT, INPUT_KEY_RIGHT };

			for (int i = 0; i < 4; i++) {
				bool is_hit = hit[i];

				if (alt_mode_hits[i] != is_hit) {
					alt_mode_hits[i] = is_hit;
					input_report_key(btn_dev, zephyr_codes[i], is_hit ? 1 : 0, true, K_FOREVER);
				}
			}
		}
	}
}
K_THREAD_DEFINE(hid_report_tid, 2048, hid_report_thread, NULL, NULL, NULL, K_PRIO_PREEMPT(5), 0, 0);

static void imu_monitor_cb(struct k_timer *timer)
{
	static uint32_t last_trigger_count = 0;
	uint32_t trigger_count = atomic_get(&imu_trigger_count);
	uint32_t trigger_delta = trigger_count - last_trigger_count;
	last_trigger_count = trigger_count;

	uint32_t accel_clip_cnt = atomic_get(&accel_clip_count);
	uint32_t gyro_clip_cnt = atomic_get(&gyro_clip_count);

	// TODO: Does this handle the overflow correctly?
	if (trigger_delta == 0) {
		LOG_ERR("IMU trigger stall, trigger: %u (total: %u), clip: a: %u, g: %u", trigger_delta, trigger_count, accel_clip_cnt, gyro_clip_cnt);
	} else {
		LOG_DBG("trigger: %u (total: %u), clip: a: %u, g: %u", trigger_delta, trigger_count, accel_clip_cnt, gyro_clip_cnt);
	}
}
K_TIMER_DEFINE(imu_monitor_timer, imu_monitor_cb, NULL);

int motion_engine_init(void)
{
	if (dev_imu == NULL || !device_is_ready(dev_imu)) {
		LOG_ERR("IMU is not ready");
		return -ENODEV;
	}

	if (dev_mag == NULL || !device_is_ready(dev_mag)) {
		LOG_ERR("Magnetometer is not ready");
		return -ENODEV;
	}

	int ret;

	struct sensor_value accel_fs;
	sensor_g_to_ms2(LSM6DSL_ACC_FULL_SCALE, &accel_fs);
	accel_clip_limit = sensor_value_to_float(&accel_fs) * 0.98f;
	ret = sensor_attr_set(dev_imu, SENSOR_CHAN_ACCEL_XYZ, SENSOR_ATTR_FULL_SCALE, &accel_fs);
	if (ret < 0) {
		LOG_ERR("Failed to set accelerometer range: %d", ret);
		return ret;
	}

	struct sensor_value gyro_fs;
	sensor_degrees_to_rad(LSM6DSL_GYR_FULL_SCALE, &gyro_fs);
	gyro_clip_limit = sensor_value_to_float(&gyro_fs) * 0.98f;
	ret = sensor_attr_set(dev_imu, SENSOR_CHAN_GYRO_XYZ, SENSOR_ATTR_FULL_SCALE, &gyro_fs);
	if (ret < 0) {
		LOG_ERR("Failed to set gyroscope range: %d", ret);
		return ret;
	}

	struct sensor_value odr_value;
	ret = sensor_value_from_float(&odr_value, MAG_SAMPLING_FREQUENCY);
	if (ret < 0) {
		LOG_ERR("Failed to convert sampling frequency to sensor value: %d", ret);
		return ret;
	}

	ret = sensor_attr_set(dev_mag, SENSOR_CHAN_MAGN_XYZ, SENSOR_ATTR_SAMPLING_FREQUENCY, &odr_value);
	if (ret < 0) {
		LOG_ERR("Failed to set magnetometer sampling frequency: %d", ret);
		return ret;
	}


	ret = sensor_value_from_float(&odr_value, IMU_SAMPLING_FREQUENCY);
	if (ret < 0) {
		LOG_ERR("Failed to convert sampling frequency to sensor value: %d", ret);
		return ret;
	}

	ret = sensor_attr_set(dev_imu, SENSOR_CHAN_ACCEL_XYZ, SENSOR_ATTR_SAMPLING_FREQUENCY, &odr_value);
	if (ret < 0) {
		LOG_ERR("Failed to set accelerometer sampling frequency: %d", ret);
		return ret;
	}

	ret = sensor_attr_set(dev_imu, SENSOR_CHAN_GYRO_XYZ, SENSOR_ATTR_SAMPLING_FREQUENCY, &odr_value);
	if (ret < 0) {
		LOG_ERR("Failed to set gyroscope sampling frequency: %d", ret);
		return ret;
	}

	struct sensor_trigger trig = {
		.type = SENSOR_TRIG_DATA_READY,
		.chan = SENSOR_CHAN_ACCEL_XYZ,
	};

	ret = sensor_trigger_set(dev_imu, &trig, imu_trigger_handler);
	if (ret < 0) {
		LOG_ERR("Failed to set IMU trigger: %d", ret);
		return ret;
	}

	k_timer_start(&imu_monitor_timer, K_SECONDS(1), K_SECONDS(1));

	LOG_INF("Motion engine init done");
	return 0;
}

int motion_engine_suspend(void)
{
	LOG_INF("Suspending");

	k_timer_stop(&hid_report_timer);
	k_timer_stop(&imu_monitor_timer);

	int ret = pm_device_action_run(dev_imu, PM_DEVICE_ACTION_SUSPEND);
	if (ret < 0) {
		LOG_ERR("Failed to suspend the IMU: %d", ret);
	}

	ret = pm_device_action_run(dev_mag, PM_DEVICE_ACTION_SUSPEND);
	if (ret < 0) {
		LOG_ERR("Failed to suspend the magnetometer: %d", ret);
	}

	return 0;
}

int motion_engine_resume(void)
{
	LOG_INF("Resuming");

	int ret = pm_device_action_run(dev_mag, PM_DEVICE_ACTION_RESUME);
	if (ret < 0) {
		LOG_ERR("Failed to resume the magnetometer: %d", ret);
	}

	ret = pm_device_action_run(dev_imu, PM_DEVICE_ACTION_RESUME);
	if (ret < 0) {
		LOG_ERR("Failed to resume the IMU: %d", ret);
	}

	k_timer_start(&imu_monitor_timer, K_SECONDS(1), K_SECONDS(1));
	k_timer_start(&hid_report_timer, HID_REPORT_INTERVAL, HID_REPORT_INTERVAL);

	return 0;
}
