pietrmar/theadmouse/firmware/src/button_manager.h

#pragma once

#include "at_cmd.h"

int button_manager_init(void);

int button_manager_set_mapping(size_t idx, const uint16_t at_code, const uint16_t at_code_release, const struct at_cmd_param *at_param);
int button_manager_get_mapping(size_t idx, uint16_t *at_code, struct at_cmd_param **at_param);
int button_manager_delete_mapping(size_t idx);

char *button_manager_get_button_state_string(char *buf, size_t size);

extern const size_t button_manager_num_buttons;

static inline bool button_manager_valid_index(size_t idx)
{
	return idx < button_manager_num_buttons;
}

static inline size_t button_manager_get_num_buttons(void)
{
	return button_manager_num_buttons;
}
