pietrmar/theadmouse/(commit log)

2025-03-02 firmware: prj.conf: enable shell, i2c, and sensor support
2025-03-02 firmware: app.overlay: enable i2c0 bus and sensors
2025-03-22 firmware: prj.conf: enable reboot and retained memory drivers
2025-04-13 firmware: main.c: add `reboot` command
    [main.c]
2025-04-13 firmware: add and enable NUS (Nordic UART Service)
2025-04-13 firmware: main.c: read sensor data and pass send it out over HOG
2025-04-13 firmware: implement sensor fusion with Madgwick AHRS algorithm
2025-04-15 firmware: drivers: add lsm6dsl driver from v4.0.99-ncs1-2 to the source tree
    This will make it possible for us to make modifications.
2025-04-15 firmware: drivers: add custom lsm6dsl driver from the v3.7.99-ncs2 source tree
2025-04-15 firmware: drivers: lsm6dsl: fetch gyro and accel values in one batch
    This improves the time slightly to fetch both from ~750 us to ~550 us.
2025-04-15 firmware: drivers: lsm6dsl: set custom thread name on own trigger thread
2025-04-15 firmware: prj.conf: switch to custom lsm6dsl driver and use own trigger
2025-05-06 firmware: drivers: lsm6dsl: use level interrupt
    Otherwise it is possible to lose interrupts at higher sample-rates.
    Alternatively it could be possible to re-enable interrupts before the
    custom interrupt thread is done.
2025-06-28 firmware: main.c: fix typo
    [main.c]
2025-08-08 hardware: add RevA of the (almost) finished PCB design
    This is mostly finished, just needs a bit of additional information on the
    silk-screen and a few mor sporadic checks.
    [Buzzer_FUET_FST-9018_9x9mm.FCStd, Jack_3.5mm_KoreanHropartsElec_PJ-320D-4A_Horizontal_Custom.step, LED_Green_MEIHUA_MHS110UGCT_Horizontal.FCStd, LED_RGB_TUOZHAN_P4-1204RGBWS2-1.5T-A_Horizontal.FCStd, Module_RF_Ebyte_E73-2G4M08S1C_Castellated.step, Pin Assignment.ods, RJ25_TE_215876-1_Horizontal.step, SW_Push_1P1T-MP_NO_Horizontal_Alps_SKRTLAE010_Custom3D.step]
2025-08-09 hardware: RevA: create production output for JLCPCB
    These files were used to place the RevA order at JLCPCB.
    [bom.csv, designators.csv, positions.csv, theadmouse.kicad_pcb]
2025-08-11 scripts: add basic flash.sh script utilizing the Black Magic Debug probe
2025-08-12 firmware: main.c: generate a friendly device name from the unique device ID
2025-08-12 firmware: main.c: log the error return code of `settings_load_subtree()`
    [main.c]
2025-08-13 firmware: main.c: append 2 bytes of the device ID for the name
    The adjective + noun pair was a bit too much, so now use `theadmouse-<aa><bb>`
    where <aa> and <bb> are the last two bytes of the device ID.
    [main.c]
2025-08-14 firmware: add boilerplate code for the theadmouse board
2025-08-21 firmware: boards: theadmouse: initial board bringup
    Configures the following:
    - PWM for the RGB LED and the piezo buzzer
    - SPI in 4-wire mode (needs R40 stuffed on RevA)
    - LSM6DSL IMU
    - LIS2MDL Magnetometer
    - UART
2025-08-21 firmware: prj.conf: some minor clenaups for board bringup
    This does the following:
    - move board specific things like LSM6DSL settings to the board file
    - enable CONFIG_CPU_LOAD feature to allow to show the CPU load
    - increase log buffer
    - disable boot delay
2025-08-21 firmware: main.c: minor cleanups for board bringup
    The main.c basically needed 0 changes for the previous state to work on our
    new board, thanks to the Zephyr framework.
    Only minor things and cleanups have been done.
2025-08-21 firmware: remove custom lsm6dsl driver for now
    I will take a detailed look at this later, but for now the demo is working
    with the driver from Zephyr unmodified.
2025-09-08 firmware: boards: theadmouse: switch the nrf52840 to use the DCDC converter
    This reduces the power consumption from 3.92 mA to 2.65 mA in the current
    application, which is a lot.
2025-09-22 firmware: board: add first support for the Puck.js
    This just has the RGB LED, I2C0 and the LSM6DSL defined.
2025-10-15 firmware: boards: theadmouse: move reg1 node into the right place
2025-10-15 firmware: boards: theadmouse: enable LIS2MDL runtime ODR setting
2025-10-16 firmware: boards: theadmouse: add 2 UART ports over USB
2025-10-16 firmware: main.c: make NUS debug output conditional on THEADMOUSE_NUS_DEBUG
    We will probably remove it very soon and instead use a USB UART port to
    send some debug data.
2025-10-16 firmware: main.c: fix log message format
    [main.c]
2025-10-16 firmware: main.c: first implementation of reading the magnetometer
    Just for a quick test, however it does not work fully yet.
    [main.c]
2025-11-03 firmware: boards: theadmouse: configure 0x1209:0x7EAD VID:PID for USB
    The VID and PID pair was requested from pid.codes in the following
    (currently pending) pull request:
    - https://github.com/pidcodes/pidcodes.github.com/pull/1112
2025-11-06 firmware: telemetry_uart: fix error message
    [telemetry_uart.c]
2025-11-06 firmware: telemetry_uart: make the write call serialized
    This will prevent interleaved output in case there are multiple writers and
    the ringbuffer became full so that only a partial write was done.
    [telemetry_uart.c]
2025-11-06 firmware: add firstversion cmd_uart driver for the AT style command interface
    This currently does not have an AT command parser yet.
2025-11-06 firmware: main.c: enabled cmd uart interface
2025-11-06 firmware: boards: theadmouse: set `mpi-cmd-uart` chosen node
2025-11-07 firmware: telemetry_uart: small fixes
    [telemetry_uart.c, telemetry_uart.h]
2025-11-07 firmware: change USB device product name to TheadMouse
2025-11-07 firmware: at_cmd: ID: include PressureSensor and ForceSensor fields in the reply
    The WebGUI expects these values, so for now keep them hardcoded.
2025-11-08 firmware: at_cmd: use "TwoCC" mechanism for the AT command codes
    The internal AT code is just the ASCII representation of the command
    stuffed into a 16-bit value.
    This makes conversion between the code and a string trivial and a the same
    time it allows us to work with the code only defined in one place at the
    `at_cmds[]` table without too much macro magic.
    [at_cmd.c, at_cmd.h]
2025-11-08 firmware: at_cmd: add mutex when calling command callbacks
    As the comment says, it's better to enqueue the commands, but in case of
    a string parameter we would need to allocate memory for it. So let's wait
    with doing this untile we have string inlining and maybe some slab
    allocator.
2025-11-08 firmware: at_cmd: fail command if a specified parameter is missing
    [at_cmd.c]
2025-11-08 firmware: add button_manager
    This just takes button presses (or later other inputs) and dispatches AT
    commands from a table. Simple but works.
    The buttons can be defined in the device-tree.
2025-11-08 firmware: main: call `button_manager_init()`
    This currently does nothing, but let's just call it.
2025-11-08 firmware: prj.conf: enable the input subsystem and the GPIO input key driver
2025-11-08 firmware: boards: theadmouse: add the GPIO buttons
2025-11-08 firmware: button_manager: add `button_manager_valid_index()` and use `size_t` for `idx`
2025-11-08 firmware: at_cmd: add first basic implementation of `AT BM <button>`
    These should be implemented cleaner, see the comments that were added.
2025-11-10 firmware: main: run the IMU at 208 Hz for now
    Otherwise it looks like we are losing interrupts and are get stuck, we
    need to optimize and debug the LSM6DSL driver at a later point in time.
    [main.c]
2025-11-11 firmware: boards: theadmouse: add custom flash partition layout
2025-11-12 firmware: at_cmd: reworkt the API a bit
    - Separate the parsing step into a `at_parse_line_[inplace|copy]()` function
    - Provide `*_inplace()` and `*_copy()` variants for parsing and handling
    - Add flags for parsing, for exampel to allow executing commands without the
    AT prefix
    [at_cmd.c, at_cmd.h]
2025-11-13 firmware: boards: theadmouse: increase storage partition size to 128 KiB
2025-11-13 firmware: button_manager: add new functions
    - Fix parameters in `button_manager_set_mapping()`
    - Add `button_manager_get_mapping()`
    - Add `button_manager_get_num_buttons()`
    [button_manager.c, button_manager.h]
2025-11-13 firmware: add first version of the slot_manager module
2025-11-13 firmware: main: call `slot_manager_init()`
2025-11-13 firmware: at_cmd: LA: use `slot_manager_dump_all_slots()`
2025-11-13 firmware: at_cmd: add TODO comment about possibly interleaving AT print functions
2025-11-13 firmware: slot_manager: almost full implementation of the slot handling
    The one things that is missing here is still the deletion of slots.
    [slot_manager.c, slot_manager.h]
2025-11-13 firmware: main: move IMU and magnetometer initialization later
    This still has some issues where we sometimes lose an interrupt and it's
    stuck, but that's ok for now, as this is not our current focus.
    [main.c]
2025-11-13 firmware: main: make `led_set_rgb()` non-static for now
    We anyway need a better way to manage the LED state properly.
2025-11-13 firmware: at_cmd: implement slot management commands and color command
2025-11-13 HACK: firmware: prj.conf: increase input and shell thread stack size
    The AT command parsing and dispatching seems to take up quite some stack
    space. After we implement queuing of AT commands on a main queue we can
    revert this.
2025-11-14 firmware: remove NUS BLE related code
    We will not use this for debugging of the IMU and sensor fusion anymore,
    instead we will use the USB-UART telemetry stream.
2025-11-15 firmware: button_manager: add TODO comment about using callbacks
2025-11-15 firmware: at_cmd: rework parameter handling and functions and add inline string
    This moves the at_cmd_parameter functions and types into separate files
    and introduces an inline string inside `struct at_cmd_param`.
    Currently heap-strings are not implemented yet.
    [at_cmd.c, at_cmd.h, at_cmd_param.c, at_cmd_param.h]
2025-11-15 firmware: button_manager: use new AT command queue
2025-11-15 firmware: slot_manager: directly dispatch AT commands during slot loading
    The slot loading happens from the thread that works through the AT command
    queue, so we cannot put items back into the queue here, instead we have
    to directly dispatch them.
    This is ok as the AT queue processing is not running at this point.
2025-11-17 firmware: at_cmd: make sure commands are dispatched only from the AT command thread
2025-11-17 src: slot_manager: make `slot_manager_load_slot_by_index()` public
2025-11-17 firmware: at_cmd: add internal commands and a command to load a slot by the index
2025-11-17 firmware: slot_manager: load slot 0 by enqueueing it on the AT command queue
    This will ensure that the initial slot loading happens from the correct
    thread.
    [slot_manager.c]
2025-11-18 firmware: at_cmd: implement `at_cmd_enqueue_and_wait_*()` functions
    Currently we only support K_FOREVER for the timeout for now, otherwise
    we would need to slab allocate the `result_ptr` and `done_sem` and use
    some reference counting.
2025-11-18 firmware: main: wait for AT command to finish and print error code
    [main.c]
2025-11-18 firmware: slot_manager: add comment about the parser returning cmd == NULL
2025-11-18 firmware: at_cmd: handle an empty command more elegantly
    The previous way of setting `*out_cmd = NULL` when an no command was
    specified was unly and inconsistent. Instead we can now make use of a
    "dummy" internal command that correctly prints OK.
    [at_cmd.c, at_cmd.h]
2025-11-18 firmware: slot_manager: drop `cmd == NULL` check
2025-11-19 firmware: button_manager: add printing of sync and print value as signed
2025-11-19 firmware: cmd_uart: fix error log of correct value
    [cmd_uart.c]
2025-11-19 firmware: cmd_uart: add log message when the UART port is not ready
2025-11-19 firmware: slot_manager: add stubbed handling of the mouse input mode
    This is just so we can serialize the mode to the `AT MM` command for now,
    mostly so that the Web-GUI is not complaining.
2025-11-19 firmware: slot_manager: make next slot loading logic more robust
    This adds more checks and log messages to the logic.
2025-11-19 firmware: add headmouse_input module
    This creates two virtual input devices that can be used to push events
    which then will be sent using HID over GATT.
2025-11-19 firmware: at_cmd: ID: use error code from `at_replyf()` and add TODO comment
    [at_cmd.c]
2025-11-19 firmware: at_cmd: MM: use `hm_input_report_rel()` now
    This will now correctly push the event into the input device, so we can
    handle it properly.
    [at_cmd.c]
2025-11-19 firmware: remove IMU/MAG related things for now
    We will do this later correctly after we cleanly implemented HID over GATT
    and such.
    [main.c]
2025-11-19 firmware: main: fix deprecation warning for `BT_LE_ADV_CONN`
    [main.c]
2025-11-25 firmware: add ble_hid_service
    This contains a keyboard HID descriptor as well a descriptor for a mouse
    with a scroll-wheel.
    There are no advanced features, just read from the queue and pass the reports
    to the `bt_hids_inp_rep_send()` function, seems to work good enough for now.
2025-11-26 firmware: add initial motion_engine module
    Currently does not much, just tracks interrupts.
2025-11-26 firmware: prj.conf: use custom LSM6DSL driver
2025-11-26 firmware: boards: theadmouse: use lsm6dsl for the `mpi,imu` chose node
2025-11-29 firmware: drivers: add lis2mdl driver from v4.0.99-ncs1-2 to the source tree
2025-11-29 firmware: prj.conf: use custom LIS2MDL driver
2025-11-29 firmware: drivers: lis2mdl: switch SPI mode correctly to 4 wire
    The `lis2mdl_spi_mode_set()` function performs a read-modify-write, however
    if we are not in 4 wire mode yet, then reading over SPI might give us 0xFF
    so the function will write 0xFF to the register, enabling things like the
    self-test mode which is bad.
    Instead just write the desired value directly to the register.
    [lis2mdl.c]
2025-11-29 firmware: ble_hid_service: fix error log message
    [ble_hid_service.c]
2025-12-02 firmware: MadgwickAHRS: make sampleFreq configurable
2025-12-02 firmware: boards: theadmouse: use lis2mdl for `mpi,mag` chosen node
2025-12-02 firmware: prj.conf: enable LSM6DSL temperature readout
2025-12-02 firmware: motion_engine: finish first implementation using Madgwick filter
    This uses the IMU using a simple gyro bias compensation and a Madgwick
    filter.
    For now it just pushes out HID updates and seems to work ok, no advanced
    features are implemented yet.
2026-01-14 firmware: slot_manager: add `slot_manager_get_active_slot_idx()` function
2026-01-14 firmware: at_cmd: clamp WA command at 1000 ms and print a warning
2026-01-14 firmware: at_cmd: first implementation of periodic reporting
    Currently it only reports the currently active slot index.
2026-01-14 firmware: slot_manager: prevent recursive slot loading
    [slot_manager.c]
2026-01-20 firmware: button_manager: add `button_manager_get_button_state_string()` function
    This reports the current state of all buttons as a string of 1 and 0.
2026-01-20 firmware: button_manager: add comment about enqueueing of commands which might have a heap string
2026-01-20 firmware: at_cmd: include button states in periodic reporting
2026-01-20 firmware: at_cmd_param: change at_cmd_param_[clone|free]() API
    This changes the behavior assuming that the caller has already allocated
    the struct and this only handles the "deep" copy aspect, which currently
    is the case for a heap allocated string.
2026-01-20 firmware: button_manager: inline the whole `struct at_cmd_param` inside the button_mapping struct
    We still need to make sure a potential heap string is copied to an allocated
    heap object. Currently heap strings are not implemented yes in the parser
    fully, but this should already prepare the button_manager for it correctly.
    [button_manager.c]
2026-01-21 firmware: add common.h header
    Currently this only contains a generic enum definition for an axis.
2026-01-21 firmware: motion_engine: correctly accumulate IMU updates and provide an absolute HID position
    This change does the following:
    - Calculate delta movements at the IMU rate and accumulate them until the
    HID thread reads them out and re-sets the accumulator to 0. This prevents
    aliasing effects and makes sure we are making use of all IMU updates
    correctly.
    - Accumulate an abolute HID position in the HID thread and provide a way to
    reset it. For now this will be only used in the reporting functionality.
    - Make the sensitivity configurable externally
    [motion_engine.c, motion_engine.h]
2026-01-21 firmware: at_cmd: implement CA command to reset the absolute HID position
    [at_cmd.c]
2026-01-21 firmware: slot_manager: serialize sensitivity as AX, AY commands on save
2026-01-21 firmware: motion_engine: handle float remainder of HID position updates
    We can only send HID position updates that are whole integers, and
    potentially we could have up to half a pixel in the remainder which would
    be then lost. So the remainder keeps track of this.
2026-01-21 firmware: keymaps: add keyboard layouts from the Arduino Keyboard library
    These files were committed unmodified from the following repo:
    - https://github.com/arduino-libraries/Keyboard
    commit id: 05d7c488c9a4e77a2a4643270bffda4dfc4e5dee
2026-01-21 HACK: firmware: at_cmd: allow the string parameter to be empty
    Some commands like KL for example are expected to print the current value
    of the setting when no parameter was passed.
    This HACK allows to do this but it is not very nice, instead there should
    be some kind of flag indicating that the parameter is optional.
2026-01-21 firmware: slot_manager: serialize KL setting on save
2026-01-21 firmware: at_cmd: more consistent error message for the KL command
    [at_cmd.c]
2026-01-22 firmware: at_cmd: ID: report ForceSensor=IMU
2026-01-22 firmware: slot_manager: use new motion_engine function names
2026-01-22 firmware: slot_manager: remove old input mode setting as it was moved to the motion_engine
2026-01-23 firmware: at_cmd: correctly allow optional parameters
    [at_cmd.c, at_cmd.h]
2026-01-23 firmware: slot_manager: serialize DX, DY values on save
2026-01-23 firmware: at_cmd_param: add AT_CMD_PARAM_TYPE_KEYS
    This is just an array of uint8_t which will store the intermediate code
    representation of the parsed KEY_*/KEYPAD_* parameters.
    The union is already 16 bytes in size because of the inline string, so just
    make the maximum number of simultaneous keys also 16, even if we currently
    only support 6-key rollover in our HID implementation.
2026-01-23 firmware: at_cmd: add parsing and serializing of AT_CMD_PARAM_TYPE_KEYS
    Also print the partial string on error for better debugging purposes.
    [at_cmd.c]
2026-01-23 firmware: button_manager: allow to provide an AT command for key release
2026-01-23 firmware: at_cmd: add a new flag AT_CMD_FLAG_HOLD
    When this flag is set it is possible to pass an AT command code in the
    ctx that will be enqueue (with the same parameters) by the button manager
    when the button is released.
    This is not the cleanest architecture, but for now it'll do.
2026-01-23 firmware: button_manager: add input key-codes for UP, DOWN, LEFT and RIGHT
2026-01-24 firmware: dts: bindings: add pwm-spk binding definition
2026-01-24 firmware: slot_manager: play notes from the C major scale on slot change
    If we have more than 8 slots we do not wrap around but simply play the
    highest note. To me this seems less confusing than wrapping around.
2026-01-24 firmware: boards: theadmouse: add the PWM speaker
2026-01-26 firmware: prj.conf: fix BLE pairing settings
    This makes is not more easily possible to have multiple paired devices and
    also allows a client to easily reconnect even if it has unpaired.
2026-01-27 firmware: boards: theadmouse: disable the telemetry UART stream
    This is not the cleanest way, but for now let's keep it disabled.
2026-01-29 firmware: at_cmd: correctly format ID reply for the WebGUI
    [at_cmd.c]
2026-04-30 firmware: prj.conf: enable power management
2026-04-30 scripts: flash.sh run detach command before quit
    This prevents an extra print about the remote target still being active and
    seems cleaner to me.
2026-05-08 firmware: button_manager: report activity on button presses
2026-05-08 firmware: app_power_manager: fix typo in commend
    [app_power_manager.c]
2026-05-08 firmware: ble: add comment about flushing queues when a device connects
2026-05-12 hardware: RevA: re-export project in KiCad version 10
    [sensors.kicad_sch, theadmouse.kicad_pcb, theadmouse.kicad_sch, user-interface.kicad_sch]
2026-05-12 hardware: RevA: update all symbols and remove embedded datasheet PDF files
    [theadmouse.kicad_sch]
2026-06-16 firmware: dts: bindings: rename `pwm-spk` binding to `mpi,pwm-spk`
2026-06-16 firmware: boards: theadmouse: use new `mpi-pwm-spk` compatible
2026-06-16 firmware: slot_manager: rename `slot_manager_play_note()` to `_play_tone()`
    This is a bit more accurate.
2026-06-16 firmware: dts: bindings: add `mpi,pwm-rgbled` binding
2026-06-16 firmware: main: remove `led_set_rgb()` function
    This functionality will be moved into the slot manager instead.
2026-06-16 firmware: slot_manager: implement `slot_manager_set_rgb_led_color()`
2026-06-16 firmware: slot_manager: add comment about not immediately setting the RGB LED color
2026-06-16 firmware: boards: theadmouse: use new device-tree bindings for the PWM RGB LED
2026-06-16 firmware: main: implement slot_manager commands for debugging and measurements
2026-06-17 firmware: motion_engine: use timer based scheduling for generating HID reports at 100 Hz
    This also allows us to disable/enable the timer when entering/leaving the
    suspend mode.
2026-06-17 firmware: main: sleep forever
    This prevents the thread from waking up every second for no reason.
    [main.c]
2026-06-17 firmware: app_power_manager: disable the UART when entering suspend mode
    The UART consumes ~450 uA, which is a lot, with the UART disabled we can
    reach ~26.5 uA in idle mode.
2026-07-03 firmware: drivers: add bq2518x driver from ncs-v3.3.1 to the source tree
2026-07-03 firmware: slot_manager: add suspend and resume functions
    This is not the final version yet because there could be race conditions
    with incoming AT commands.
2026-07-03 firmware: app_power_manager: suspend and resume the slot_manager
2026-07-03 firmware: boards: theadmouse: add bq25186 charger
2026-07-03 firmware: boards: theadmouse: remove CONFIG_LED and CONFIG_LED_PWM
2026-07-03 firmware: prj.conf: enable custom BQ2518X driver and the I2C shell
2026-07-03 firmware: prj.conf: add commented out configs for the thread analyzer
2026-07-03 firmware: main: add `charger status` command
2026-07-10 firmware: drivers: bq2518x: control `TS_EN` bit from devicetree
    Property to disable the NTC based control of the charger.
    [taken from upstream Zephyr into the custom driver]
2026-07-10 firmware: drivers: bq2518x: add `push-button-disable` flag
    This disables the push button functionality ans allows us to save a bit
    more power.
2026-07-10 firmware: boards: theadmouse: disable bq25186 NTC control and push button feature
